flashdato/3DSM_Project/docs/images/arm_viz.png

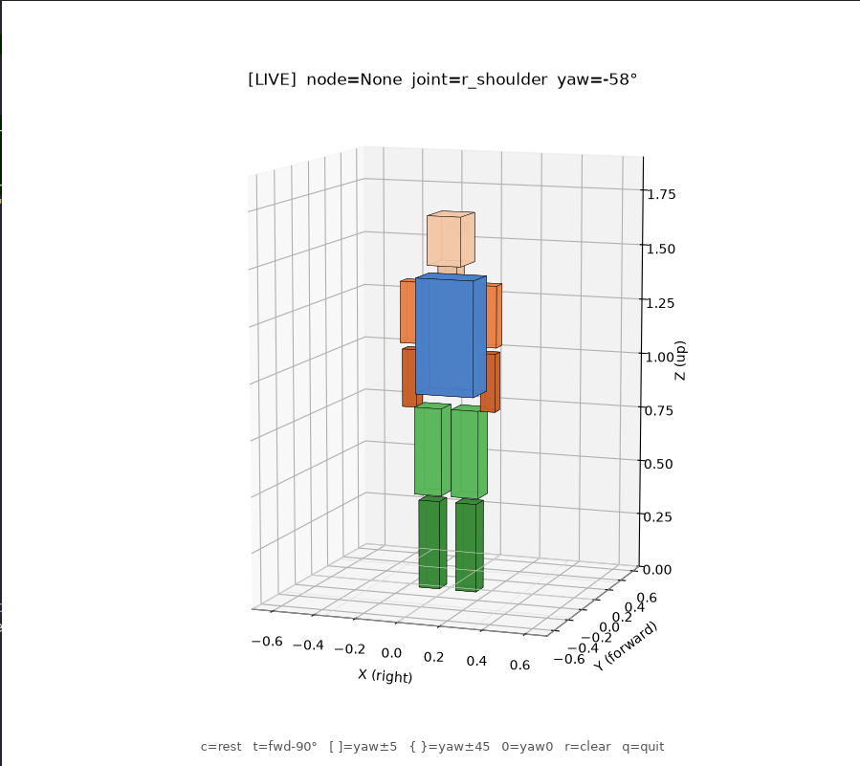
docs/images/arm_viz.png
