flashdato/3DSM_Project/docs/images/box_viz.png

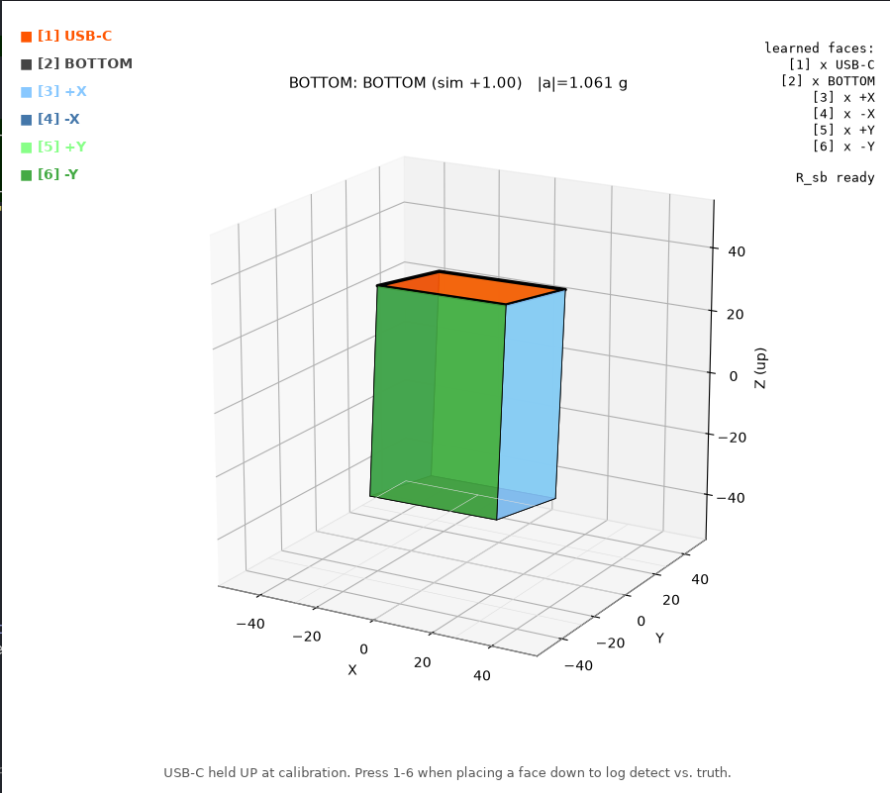
docs/images/box_viz.png
