flashdato/3DSM_Project/(commit log)

2026-09-22 Initial commit: Phase 1 kinematic model + web demo
    - 10-segment human model with kinematic tree, forward kinematics
    - Predefined wave + squat animations
    - Python matplotlib local dev viewer (src/)
    - Three.js browser demo for GitHub Pages (docs/)
    - Full 5-phase project roadmap in PLAN.md
2026-09-24 3DSM v0.2: hardware bring-up plan
    - HARDWARE.md: 2-node right-arm setup (ESP32 + GY-87 over ESP-NOW to a
    receiver ESP32), rate budgets, beacon time sync, packet format, wiring
    - firmware/: sensor_node and receiver sketches (compile on ESP32/ESP32-S3)
    - tools/log_serial.py: records receiver stream to recordings/
    - Web demo and Python viewer: right arm only, with IMU nodes and live
    elbow/shoulder angles; full body kept behind --full / Body outline
    - README reduced to the current version; history in CHANGELOG.md,
    background in PROJECT.md; PLAN.md Phase 3/4 updated
    - .gitignore: recordings, professor materials, IDE settings
    Claude-Se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
2026-09-25 3DSM v0.3 WIP: virtual IMU + live sensor charts
2026-10-08 3DSM v0.4: wireless IMU + per-sensor box & arm viz
    Real GY-87 hardware now drives the model wirelessly over ESP-NOW, with a
    mounting calibration learned once per sensor and persisted so launches
    start in LIVE mode. Orientation is pure accel + gyro (clone board's mag
    is unusable).
    - firmware/esp32_sensor_now + esp32_receiver_now: broadcast ESP-NOW link,
    200 Hz / 4 samples per pkt, boot-time gyro bias calibration, 1 Mbaud
    CSV out, per-node sequence tracking + reconnect notice.
    - tools/visualize_box_gy87.py: 6-face mounting learn via keys 1-6, Kabsch
    solver, Mahony-style accel+gyro filter with online bias refinement.
    Mounting persists per node under calibrations/.
    - tools/visualize_arm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
2026-10-09 3DSM v0.5: two-arm live tracking + guided calibration + rest-anchor
    Second IMU node drives the right upper arm; the right arm's shoulder and
    elbow are now tracked by sensors in real time. Calibration is a 3-pose
    guided flow with ghost preview on the viewer. Gyro-only yaw drift between
    the two sensors (which showed up as the elbow "curling by itself" after a
    few motion cycles) is zeroed out automatically every time the arm returns
    to rest.
    - Receiver CSV tags every sample with D,<node_id>, so interleaved streams
    from both nodes route to the right per-node filter.
    - visualize_arm_now.py rewritten for two concurrent nodes with per-node
    R_sb, Mahony filter, rest_W, yaw_rad. Elbow chain:
    r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
    [esp32_receiver_now.ino, esp32_sensor_now.ino, visualize_arm_now.py, visualize_box_gy87.py]
